NabuCasa/yellow/(threads)

Thread 60 (2023-04-10):

BOM File

gui28347, 2023-04-10:
Could you include the bom file in the release of project ?

agners, 2023-08-21:
Our BOM workflow is rather custom because of requirements from our factory.

However, you can use the KiCad design files to generate a BOM file rather easily.

Closed 2023-08-21.

Thread 61 (2023-04-21):

Fan header and RGB lights

t3hk0d3, 2023-04-21:
Is there any reason why they are not mentioned anywhere in documentation?

agners, 2023-05-10:
They aren't soldered on, so we didn't deem to document those. Especially the controller for the RGB lights wouldn't be easy to populate for most people. And folks who can do it are probably fine looking at the schematics/layout directly :smile:

t3hk0d3, 2023-05-10:
@agners Just out of curiosity - what is a point having these on PCB, but never soldering them? Base for future versions/modifications?

agners, 2023-05-10:
> @agners Just out of curiosity - what is a point having these on PCB, but never soldering them? Base for future versions/modifications?

Essentially component shortage fallout. It was late to implement PCB modifications so we just went for assembly options. We did consider adding it later, but it seems a bit late at this point, since people are used to and documentation has been written etc. etc..

agners, 2023-05-10:
> I am still trying to figure out how to make them work with device tree :D

Yeah that was the other problem: I think it requires kernel source modifications as well :sweat_smile:

Here you can find some nuggets to get that going :smile:
<https://github.com/NabuCasa/raspberrypi-linux/commits/rpi-5.10.y-ha-led-lp5569-forums>

t3hk0d3, 2023-05-15:
> > @agners Just out of curiosity - what is a point having these on PCB, but never soldering them? Base for future versions/modifications?
>
> Essentially component shortage fallout. It was late to implement PCB modifications so we just went for assembly options. We did consider adding it later, but it seems a bit late at this point, since people are used to and documentation has been written etc. etc..

Any chance for `Home Assistant Yellow Max` version? 😉

Closed 2023-05-10.

Thread 63 (2023-08-21):

Google Coral USB Stick

arne182, 2023-08-21:
Is there a way to get a USB 3.0 interface so that I can use the full potential of the Google Coral Stick?

agners, 2023-08-21:
The Raspberry Pi Compute Module 4 has no native USB 3.0 support. The way USB 3.0 is implemented on Raspberry Pi and other boards is through a PCIe to USB 3.0 bridge.

On Yellow the PCIe lines are routed to the M.2 connector. Technically, you can use a M.2 PCIe to USB 3.0 adapter, but they don't seem all that common in practice.

Anther way would be to build a M.2 module with a PCIe to USB 3.0 bridge and a Coral on-board. It seems that there are designs out there for such a device, see https://github.com/will127534/Coral-USB3-M2-Module.

But from a Yellow perspective, there is no plans to build a variant which comes with a PCIe to USB 3.0 bridge on-board.

Closed 2023-08-21.

Thread 64 (2024-11-27):

Will Home Assistant Yellow Be Compatible with CM5?

jotai-dev, 2024-11-27:
I’m considering purchasing the Home Assistant Yellow. Currently, I plan to use the CM4, but I’d like to upgrade to the CM5 once it becomes available. Will this be possible?

I checked the [forward guidance PDF](https://pip.raspberrypi.com/categories/945-forward-guidance) and noticed that some pinouts have been changed on the CM5. Will this affect compatibility?

Closed 2024-11-28.
