NabuCasa/yellow/(commit log)

2021-01-12 Initial commit
    Project creation, imported Compute Module 4 symbol and footprint from
    Gitlab merge requests:
    https://gitlab.com/kicad/libraries/kicad-symbols/-/merge_requests/3158
    https://gitlab.com/kicad/libraries/kicad-footprints/-/merge_requests/2562
    [CM4.kicad_sch, LightBlue.kicad_pcb, LightBlue.kicad_sch]
2021-01-12 Add symbols to schematics, add Symbol for stacked USB 2.0 connector
    [CM4.kicad_sch, LightBlue.kicad_sch, USB.kicad_sch]
2021-01-12 Add USB2422 2-Port Hub and footprint
    [LightBlue.kicad_sch, USB.kicad_sch]
2021-01-13 Add Molex 2086588131 HDMI connector
    [CM4.kicad_sch, LightBlue.kicad_sch]
2021-01-13 Add Silicon Labs MGM210P symbol and footprint
    [LightBlue.kicad_sch, Radio.kicad_sch]
2021-01-13 Add sheet for audio
    [Audio.kicad_sch, LightBlue.kicad_sch]
2021-01-13 Add Ethernet plug symbol and footprint
    [Ethernet.kicad_sch, LightBlue.kicad_sch]
2021-01-14 Add PCIe M.2 support
    [LightBlue.kicad_sch, PCIe.kicad_sch]
2021-01-14 Wire up PCIe/M.2 connector
    [CM4.kicad_sch, LightBlue.kicad_sch, PCIe.kicad_sch]
2021-01-14 Connect HDMI plug
    [CM4.kicad_sch, LightBlue.kicad_sch]
2021-01-14 Wire Ethernet
    [CM4.kicad_sch, Ethernet.kicad_sch, LightBlue.kicad_sch]
2021-01-16 Add sheet for front/RTC, add buttons, LEDs and a RGB LED
    [CM4.kicad_sch, FrontRTC.kicad_sch, LightBlue.kicad_sch]
2021-01-16 Wire up TI PCM5121 audio connect
    [Audio.kicad_sch]
2021-01-16 Multiple changes in schematic & projects:
    -Added net classes for controlled impedance traces
    -Added power hierarchical sheet
    -Initial USB subsystem schematic
    -Added multiple bus definitions (usb, pcie, i2c etc.)
    -Fixed busses use
    -Added LDO for audio analog rails
    [Audio.kicad_sch, CM4.kicad_sch, Ethernet.kicad_sch, FrontRTC.kicad_sch, LightBlue.kicad_sch, PCIe.kicad_sch, Power.kicad_sch, USB.kicad_sch]
2021-01-16 USB.kicad_sch: Fix hub DFP polarity
    [USB.kicad_sch]
2021-01-16 Changes: -Added AP64501SP-13 library symbol -Initial power supplies schematics -Increased capacitance for PCIe socket -Connections between sheets
    [Audio.kicad_sch, CM4.kicad_sch, Ethernet.kicad_sch, FrontRTC.kicad_sch, LightBlue.kicad_sch, PCIe.kicad_sch, Power.kicad_sch, USB.kicad_sch]
2021-01-16 Replace LP5562 with LP5569 for more RGB LED support
    The package is also larger and easier to assemble.
    [FrontRTC.kicad_sch]
2021-01-17 Changes -Added sdcard sheet and SD bus -changed main i2c bus -added 1.8V and 3.3V connection to CM4 -removed clk32 from led driver -fixed PCM interface Data pin
    [Audio.kicad_sch, CM4.kicad_sch, FrontRTC.kicad_sch, LightBlue.kicad_sch, PCIe.kicad_sch, USB.kicad_sch, sdcard.kicad_sch]
2021-01-17 LightBlue.kicad_sym: add SD_DETECT to CM4 symbol
2021-01-17 Wired up SD card
    [LightBlue.kicad_sch, sdcard.kicad_sch]
2021-01-17 Add UART for Zigbee and wire up control signals
    [CM4.kicad_sch, LightBlue.kicad_sch, Radio.kicad_sch]
2021-01-17 Wire up MGM210P Zigbee radio
    [Radio.kicad_sch]
2021-01-18 -Connected remaining nets -CM4 symbol fixups -Used single 6x OE buffer chip instead of 4x single -Added PWM FAN
    [Audio.kicad_sch, CM4.kicad_sch, Ethernet.kicad_sch, FrontRTC.kicad_sch, LightBlue.kicad_sch, PCIe.kicad_sch, Radio.kicad_sch, USB.kicad_sch]
2021-01-24 PoE and clean-up
    - Moved PoE to a seperate sheet and finished design
    - Started using Config field for Variants and DNP flag
    - Fix-ups
    - Added Wurth 749119550 and TI TPS23734 to the symbol library
    - Changed RTC from PCF8563 to PCF85063
    [Audio.kicad_sch, CM4.kicad_sch, Ethernet.kicad_sch, FrontRTC.kicad_sch, LightBlue.kicad_sch, PCIe.kicad_sch, Power.kicad_sch, Radio.kicad_sch]
2021-01-24 poe.kicad_sch: Flip the optocoupler
    [poe.kicad_sch]
2021-01-24 Update Manufacturer/PartNumber in Front/RTC
    [FrontRTC.kicad_sch]
2021-01-24 Update Manufacturer/PartNumber accross the whole schema
    [Audio.kicad_sch, CM4.kicad_sch, Ethernet.kicad_sch, FrontRTC.kicad_sch, LightBlue.kicad_sch, PCIe.kicad_sch, Power.kicad_sch, Radio.kicad_sch]
2021-01-24 Annotate symbools and assign capacitor footprints
    [Audio.kicad_sch, CM4.kicad_sch, Ethernet.kicad_sch, FrontRTC.kicad_sch, LightBlue.kicad_sch, PCIe.kicad_sch, Power.kicad_sch, Radio.kicad_sch]
2021-01-25 Standardize page settings/add page titles
    [Audio.kicad_sch, CM4.kicad_sch, Ethernet.kicad_sch, FrontRTC.kicad_sch, LightBlue.kicad_sch, PCIe.kicad_sch, Power.kicad_sch, Radio.kicad_sch]
2021-01-25 Define more footprints and update Manufacturer/PartNumber fields
    [CM4.kicad_sch, Ethernet.kicad_sch, FrontRTC.kicad_sch, LightBlue.kicad_sch, Power.kicad_sch, USB.kicad_sch, poe.kicad_sch, sdcard.kicad_sch]
2021-01-25 Add footprint for 3.5mm Plug CUI SJ2-35953A-SMT-TR
    Add 3.5mm Audio plug footprint for CUI SJ2-35953A-SMT-TR and assign it.
    Define Config to be +Audio for audio components.
    [Audio.kicad_sch]
2021-01-25 Add TPS23734 footprint
    Add footprint for PoE controller TI TPS23734. Also fix/readd
    Manufacturer which somehow got lost when opening.
    [LightBlue.kicad_sch, poe.kicad_sch, sdcard.kicad_sch]
2021-01-26 Define footprint for remaining parts
    - Fix footprint for 02x05 pin header
    - Add footprint for Bourns SDR1006 Inductor (PoE)
    - Define footprints for inductors
    - Define footprints for ferrite beads
    - Define footprint for fuse
    - Define footprints for all resistors
    - Define footprints for SD card and other components
    - Switch ON Semi NCP114MX with TI TLV73333PDBV
    [Audio.kicad_sch, CM4.kicad_sch, Ethernet.kicad_sch, FrontRTC.kicad_sch, LightBlue.kicad_sch, PCIe.kicad_sch, Power.kicad_sch, Radio.kicad_sch]
2021-01-26 Fix CM4 footprint, assign mounting holes/fiducials
    [CM4.kicad_sch, LightBlue.kicad_sch, poe.kicad_sch]
2021-01-26 Update Schematic to latest KiCad nightly
    [Audio.kicad_sch, CM4.kicad_sch, Ethernet.kicad_sch, FrontRTC.kicad_sch, LightBlue.kicad_sch, PCIe.kicad_sch, Power.kicad_sch, Radio.kicad_sch]
2021-01-26 Update property ids
    Make sure property ids are unique within a symbol. This should avoid
    that Manufacturer properties disappear in the future.
    [CM4.kicad_sch, Radio.kicad_sch, poe.kicad_sch, sdcard.kicad_sch]
2021-01-26 Select existing standard footprint for USB2422
    [LightBlue.kicad_sch, USB.kicad_sch]
2021-01-26 Add and assign footprint for PoE transformer
    We use Wuerth 749119550 as PoE transformer. Add and assign the footprint
    for it.
    [LightBlue.kicad_sch, poe.kicad_sch]
2021-01-26 Add Heatsink footprint
    [LightBlue.kicad_sch]
2021-01-26 Use SH as pad name for shield
    The KiCad standard HDMI symbol uses SH for shield, so use this pad name
    in the footprint as well.
2021-01-26 Use 2x5 pin header to expose extra pads of MGM210P
    [LightBlue.kicad_sch, Radio.kicad_sch]
2021-01-27 Add basic PCB outline
    Use a 120x120mm PCB with corners of radius 20mm.
    [LightBlue.kicad_pcb]
2021-01-27 Add M.2 M-Key footprint with mounting holes for 2230/2242/2260/2280
    [LightBlue.kicad_sch, PCIe.kicad_sch]
2021-01-27 Initial layout with footprint placements
    [LightBlue.kicad_pcb]
2021-01-30 Add 3D models to a couple of footprints
    Add repository with 3D models as git submodule to the repository and
    reference our footprints to the matching 3D models.
2021-02-02 [WIP] PCB commit
    [Ethernet.kicad_sch, FrontRTC.kicad_sch, LightBlue.kicad_pcb, LightBlue.kicad_sch, USB.kicad_sch, poe.kicad_sch, sdcard.kicad_sch]
2021-02-02 Add LightPipe symbol and add 6 of them to the schematics
    [LightBlue.kicad_sch]
2021-02-02 Add Light Pipes
    Add Light Pipes and densify front a bit.
    [LightBlue.kicad_pcb]
2021-02-02 Use through-hole connectors for SiLabs Debug/GPIO pin-header
    We don't plan to populate those connectors by default. The through-hole
    ones are easier to solder by hand on a populated PCB.
    [LightBlue.kicad_sch, Radio.kicad_sch]
2021-02-02 Properly name footprint according to part name
    The 1- at the start of the part number denotes M-Key which is a rather
    important distinction. Fix the footprint name.
    [LightBlue.kicad_sch, PCIe.kicad_sch]
2021-02-02 Define 3D models and offsets for KiCad footprints
    [LightBlue.kicad_pcb]
2021-02-02 Change TPD4EUSB30 symbol for pass-through routing
    Make the pads next to each input pad a passive connection as well to
    allow pass-through routing.
    [Ethernet.kicad_sch, USB.kicad_sch]
2021-02-09 PCB[WIP]/SCH:
    changes:
    -more routing
    -added poe negotiation disabled when +12V is present on the DC jack
    -modified m.2 "holes"
    [CM4.kicad_sch, LightBlue.kicad_pcb, LightBlue.kicad_sch, Power.kicad_sch, USB.kicad_sch, poe.kicad_sch]
2021-02-09 PCB[WIP]: finished routing
    TODO
    - length matching
    - review
    - silkscreen
    [Ethernet.kicad_sch, LightBlue.kicad_pcb]
2021-02-09 Fix RJ45 connector footprint
    Define that the mechanical holes have no electrical property.
2021-02-09 Update footprints to get DRC fixes
    [LightBlue.kicad_pcb]
2021-02-09 Fix DRC warnings/errors
    - Courtyard between R36 and SD card slot
    - Distance between CM4_DBG via and tracks
    [LightBlue.kicad_pcb]
2021-02-09 PCB changes
    - Moved R1 to outside of CM4 courtyard
    - Matched all diff. pairs skew
    - Increased length of the SD_CLK above all other sd traces
    - few trace fixups
    [LightBlue.kicad_pcb]
2021-02-09 Change connector reference designators
    Make them ordered logically, based importance and placement on the
    board.
    [CM4.kicad_sch, LightBlue.kicad_pcb, LightBlue.kicad_sch, Power.kicad_sch]
2021-02-09 Improve connector silkscreen placements
    [LightBlue.kicad_pcb]
2021-02-09 Improve SW and D (LED) ordering and silkscreen
    Make sure switches (SW) are ordered logically. Also use D1 through D6
    for LEDs.
    [Audio.kicad_sch, CM4.kicad_sch, Ethernet.kicad_sch, FrontRTC.kicad_sch, LightBlue.kicad_pcb, LightBlue.kicad_sch, PCIe.kicad_sch, Power.kicad_sch]
2021-02-09 Use Board Design Rules suitable for Aisler
    Bump edge to copper distance to 0.3mm. Fix a problematic via.
    [LightBlue.kicad_pcb]
2021-02-09 Fix silk screen placements
    Improve/fix most silk screen placement of most parts. Decrease size to
    0.8mm by 0.8mm and 0.15mm thickness which works for most PCB manufacturers.
    [LightBlue.kicad_pcb]
2021-02-09 PCB: Silkscreen fixups
    [LightBlue.kicad_pcb]
2021-02-09 Fix silkscreen overlap in footprints
2021-02-09 Simplify footprint of heatsink
    Only draw corner outlines.
2021-02-09 Import fixes footprints and some additional silk screen fixes
    [LightBlue.kicad_pcb]
2021-02-09 Unhide some silkscreen and place them a bit remote
    [LightBlue.kicad_pcb]
2021-02-09 Add Home Assitant logo footprint and place it on PCB
    Add a new footprint for the Home Assitant Logo and place it on the
    backside of the PCB.
    [LightBlue.kicad_pcb]
2021-02-09 Add project name and revision to silkscreen
    [LightBlue.kicad_pcb]
2021-02-11 Import fixed 3D models for stacked USB-A connector and 3.5mm Jack
    Also use the new origin of those 3D models.
    [LightBlue.kicad_pcb]
2021-02-11 More 3D model fixes
    Make sure the right path to 3D models is set in various footprints on
    the PCB. Assign the M.2 footprint from our 3D library.
    [LightBlue.kicad_pcb]
2021-02-15 Fix part number for Audio Jack
    Use 3-pin part instead of 4-pin part by defaut (SJ2-35953A-SMT-TR).
    [Audio.kicad_sch]
2021-02-15 Add CM4 board to board connectors
    Add the CM4 board to board connectors using separate symbols. This is a
    bit a hack, but makes sure two pieces appear in the BOM.
    Also, this seems to upgrade all the schematic to the latest KiCad
    schematic version.
    [Audio.kicad_sch, CM4.kicad_sch, Ethernet.kicad_sch, FrontRTC.kicad_sch, LightBlue.kicad_sch, PCIe.kicad_sch, Power.kicad_sch, Radio.kicad_sch]
2021-02-16 Fix footprint of the PoE bulk capacitor C80
    Use the correct footprint for the PoE bulk capacitor C80. The TI
    evaluation module circuit uses a Panasonic EEE-FK1J470P bulk capacitor.
    The series has other better suited alternatives like EEE-HA1J470UP, but
    the F-size code seems to be a sensible choice.
    Fixes: #1
    [LightBlue.kicad_sch, poe.kicad_sch]
2021-02-16 Replace Ohm sign with R
    Adhere to our KiCad Style Guide and use R instead of the Ohm sign.
    [Ethernet.kicad_sch, LightBlue.kicad_sch]
2021-02-16 Specify charactristics of 0805 resistor in PoE
    The reason we choose 0805 over 0402 is the required Wattage. Specify it
    in the charactristics.
    [poe.kicad_sch]
2021-03-04 Use correct Manufacturer/Part Number for SW5 (recovery switch)
    Fixes: #3
    [FrontRTC.kicad_sch]
2021-03-04 Connect RTC VDD/VSS correctly
    Fixes: #4
    [FrontRTC.kicad_sch]
2021-03-04 Use the correct Part Number for the Würth PoE Transformer
    Fixes: #2
    [poe.kicad_sch]
2021-03-04 sdcard.kicad_sch: add 10k pull-up on SD.PWR
    During boot process cm4 puts that pin briefly in input mode.
    [sdcard.kicad_sch]
2021-03-04 FrontRTC.kicad_sch: fix C64 value
    volt symbol was not capitalised.
    [FrontRTC.kicad_sch]
2021-03-04 USB.kicad_sch: Add CRFILT cap and adjust resistors
    CRFILT capacitor is required for the chip to start properly
    and 10k pull-downs were too strong according to the datasheet.
    [USB.kicad_sch]
2021-03-12 Add pull-ups for Radio.~RESET/~BOOT
    Make sure those signals are well defined even when not be driven from
    the CM4 side. Also rename Radio.BOOT to Radio.~BOOT since its a low
    active signal.
    Fixes: #10
    [CM4.kicad_sch, LightBlue.kicad_sch, Radio.kicad_sch]
2021-03-24 Replace CUI SJ2-35953A with through hole HRO PJ-3973-6A
    Use a through hole 3.5mm Audio jack to make sure it does nto get teared
    off the board accidentially that easily.
    Fixes: #9
    [Audio.kicad_sch, LightBlue.kicad_sch]
2021-04-08 Replace CP2102N and SW4
    Use a jumper instead of a switch to change between CM4 USB Device and
    CP2102N. Replace CP2102N QFN24 with QFN20 variant. Make CP2102N to be
    bus-powered by default.
    Fixes: #7
    [USB.kicad_sch]
2021-04-12 Use HRO USB-C part number to match footprint
    The footprint is not compatible with the JAE part. Specify the HRO USB-C
    part number instead.
    Fixes: #14
    [USB.kicad_sch]
2021-04-13 Replace Diodes AP64501SP-13 with Rohm BD9D321EFJ DC-DC converter
    The Rohm has a lower current rating and input voltage range, but should
    be good enough for our use case. It has better availability and is quite
    a bit cheaper than the Diodes part. This also requires different
    inductors and some different resistor values.
    Fixes: #12
    [Power.kicad_sch]
2021-04-13 Fix CP2102N footprint
    Choose Silicon Labs specific QFN20 footprint.
    [USB.kicad_sch]
2021-04-13 Redesign buttons/switches
    Remove power/reset/recovery switch. Power and reset is not really required
    and recovery mode (USB Boot) can be triggered via jumper. Make the Fan
    and RPiLED a new separate config so we can leave them unpopulated. Add a
    second GPIO controlled switch.
    Fixes: #16
    [CM4.kicad_sch, ControlRTC.kicad_sch, LightBlue.kicad_sch, USB.kicad_sch]
2021-04-13 Replace full sized HDMI with micro HDMI
    Fixes: #17
    [CM4.kicad_sch]
2021-04-13 Assign footprints and annotate components
    [Audio.kicad_sch, CM4.kicad_sch, ControlRTC.kicad_sch, Ethernet.kicad_sch, LightBlue.kicad_sch, PCIe.kicad_sch, Power.kicad_sch, Radio.kicad_sch]
2021-04-13 Power.kicad_sch: Move to ceramic capacitors
    [Power.kicad_sch]
2021-04-14 Adjust PCB outline and placement of connectors/buttons
    Adjust the PCB outline and placement of buttons and connectors for the
    next Prototype iteration.
    [LightBlue.kicad_pcb]
2021-04-14 Add ideal Diode using FET for non-PoE variant
    [LightBlue.kicad_sch, Power.kicad_sch]
2021-04-14 Adjust input/output capacitors for 5V/3.3V supply
    Add/change some capacitor to be 33uF bulk capacitors.
    [LightBlue.kicad_sch, Power.kicad_sch]
2021-04-15 LightBlue.kicad_sym: Add Pulse PA2467NL symbol
2021-04-15 PoE: Migrate to opto-less feedback topology
    [LightBlue.kicad_sch, poe.kicad_sch]
2021-04-15 Use CamelCase style naming for all schematic files
    [LightBlue.kicad_sch, PoE.kicad_sch, SDCard.kicad_sch]
2021-04-15 Adjust Manufacturer/PartNumber for some parts
    - Use Diodes B2100-13-F consistently
    - Define part for pin headers
    - Replace N-Channel MOSFET for PoE with BSZ440N10NS3GATMA1
    - Define Input protection MOSFET DMP3013SFV-7
    [CM4.kicad_sch, Ethernet.kicad_sch, LightBlue.kicad_sch, PoE.kicad_sch, Power.kicad_sch, USB.kicad_sch]
2021-04-15 Add resistors to potentially tune boost converter
    [LightBlue.kicad_sch, Power.kicad_sch]
2021-04-15 Adjust various parts to improve BOM
    - Replace unusual/high value ceramics with lower value in parallel
    - Use the same protection Shottky Diode in PoE as in regular input
    (B340LB-13-F)
    - Replace PoE rectifier Diodes with B1100-13-F
    - Replace PoE Inductor (SRN6045TA-3R3Y) with the same part from 5V power
    supply (Taiyo Yuden NRS8030T3R3MJGJ)
    - Correctly specify Pulse Electronics transformer
    [ControlRTC.kicad_sch, LightBlue.kicad_sch, PoE.kicad_sch, Power.kicad_sch, USB.kicad_sch]
2021-04-15 Reannotate the complete schematics
    [Audio.kicad_sch, CM4.kicad_sch, ControlRTC.kicad_sch, Ethernet.kicad_sch, LightBlue.kicad_sch, PCIe.kicad_sch, PoE.kicad_sch, Power.kicad_sch]
2021-04-16 Adjust rating/footprint size of some ceramic capacitors
    Also update connector/jumper designator to make more sense.
    [Audio.kicad_sch, CM4.kicad_sch, Ethernet.kicad_sch, LightBlue.kicad_pcb, LightBlue.kicad_sch, PoE.kicad_sch, Power.kicad_sch, USB.kicad_sch]
2021-04-16 Add PG-TSDSON-8-1 package for Infineon BSZ440N10NS3
    Add package for Infineon N-Channel MOSFET BSZ440N10NS3.
    [LightBlue.kicad_sch, PoE.kicad_sch]
2021-04-16 Add footprint for Pulse PA2467NL transformer
    [LightBlue.kicad_sch, PoE.kicad_sch]
2021-04-16 Use main 3.3V for CP2102N
    Instead of using VBUS to power CP2102N use the main/NVMe 3.3V supply.
    This makes sure that the device stays powered during reset, while making
    sure the CP2102N is always powered and doesn't backfeed if no USB is
    plugged in.
    [LightBlue.kicad_sch, USB.kicad_sch]
2021-04-16 Rework PCB Layout
    Adjust some high level placement like M.2 or CM4 and heatsink. Remove
    all traces and vias since most of the layouting has to be redone
    anyways.
    [CM4.kicad_sch, Ethernet.kicad_sch, LightBlue.kicad_pcb, LightBlue.kicad_sch, Radio.kicad_sch, USB.kicad_sch]
2021-04-20 Place RGB LEDs between NVMe and CM4
    [LightBlue.kicad_pcb]
2021-04-22 Increase hole size to fit M3
    The current M2.5 holes work well for the soldered nuts from JAE
    (SM3ZS067U310-NUT1-R1800). However, we are going to use a custom
    standoff with a M2 thread (nut) and a screw to mechanically secure the
    NVMe. The nut will have a border to fit the hole. That the standoff
    still can fit a M2 thread we need M3 holes.
2021-04-22 Update M.2 footprint
    Update M.2 footprint and assign 3D model.
    [LightBlue.kicad_pcb]
2021-04-22 Update board setup
    Use minimal track width/gap of 0.127mm. Use impedance calculated using
    the JLCPCB calculator for the 85Ohm/90Ohm differential pairs and 50Ohm
    single trace.
    For the 100Ohm pair the JLCPCB calculator does not allow to specify a
    track gap which leads to a track width of 0.127mm or bigger. Hence for
    this I used https://www.mantaro.com/resources/impedance-calculator.htm
    (with Er 4.05, h 0.095, t 0.035).
    Also use vias of 0.45/0.2mm by default.
    Fixes: #6
2021-04-22 Change button length and start layouting
    Change the length and positioning of the buttons and start layouting a
    bit. Move components where needed.
    [LightBlue.kicad_pcb]
2021-04-23 Use impedance for JLC7628 stackup/switch HDMI/SW2 placement
    Use JLC7628 impedance values to get more options in color selection.
    Also this leads to slightly wider traces typically, and it will be
    easier to switch back to JLC2313 or the like than the other way around.
    Also swap placing of HDMI/SW2 and rotate the heatsink by 90° for easier
    routing.
    [CM4.kicad_sch, ControlRTC.kicad_sch, Ethernet.kicad_sch, LightBlue.kicad_pcb, LightBlue.kicad_sch, USB.kicad_sch]
2021-04-27 pcb 0.2:
    Changes:
    Footrints:
    -Modified DC Jack to accomodate CUI PJ-002A
    -Modified RJ45 to increase clearance between shield and poe pins
    -Modified m.2 mounting pads to avoid drc errors
    Schematic:
    -usb-c facing usb mux is supplied by +3v3VP
    -added misc. capacitors
    PCB
    -min. annular ring for vias set to 0.125 from 0.2
    [CM4.kicad_sch, ControlRTC.kicad_sch, LightBlue.kicad_pcb, LightBlue.kicad_sch, PoE.kicad_sch, Power.kicad_sch, USB.kicad_sch]
2021-04-27 Update silkscreen/adjust reference designators
    Order some relevant reference designator. Use JP for all jumpers. Place
    silkcreen neatly. Add some custom silk screen. Remove heat sink corner
    marks on silk screen.
    [CM4.kicad_sch, Ethernet.kicad_sch, LightBlue.kicad_pcb, LightBlue.kicad_sch, PCIe.kicad_sch, PoE.kicad_sch, SDCard.kicad_sch, USB.kicad_sch]
2021-04-27 pcb fixups and cleanup
    -Moved 5V dcdc converter to clear the heatsink and the LED
    -adjusted gnd plane around the radio module
    [LightBlue.kicad_pcb]
2021-04-27 Ventilation holes and silk screen
    - Add multiple ventilation slots (move some traces for space)
    - Add Home Assistant logo to the back
    - Add Nabu Casa logo on the front
    - Fixup reference designators placement in several cases
    [CM4.kicad_sch, Ethernet.kicad_sch, LightBlue.kicad_pcb, USB.kicad_sch]
2021-04-27 Adjust edge cuts to fit case
    Make sure the PCB doesn't conflict with the case's fasteners.
    [LightBlue.kicad_pcb]
2021-04-27 Use plated slots and adjust 5V trace to be above the GND plane
    [LightBlue.kicad_pcb]
2021-05-10 Fix top right corner radii
    Make sure the top right corner uses the same radii as the other three
    corners.
    Fixes: #23
    [LightBlue.kicad_pcb]
2021-05-29 Use 0805 package for Audio 2.2uF/25V capacitors
    Fixes: #20
    [Audio.kicad_sch, LightBlue.kicad_sch]
2021-05-29 Change rating of PoE capacitors to 2.2uF/25V
    2.2uF/100V are not really available in a 0805 package. This part of
    the PoE design a 25V rating is sufficent.
    Fixes: #22
    [LightBlue.kicad_sch, PoE.kicad_sch]
2021-05-29 Clarify rating of C52/R53
    C52 needs to be 100n/25V, R53 should be 1% accuracy.
    [LightBlue.kicad_sch, PoE.kicad_sch, Power.kicad_sch]
2021-05-29 Change footprint of C87/C91 to 1206
    2.2uF/100V don't really exist in 0805 package. Use 1206 package for
    those capacitors.
    Fixes: #21
    [LightBlue.kicad_sch, PoE.kicad_sch]
2021-05-29 Use 3D model for Lite-OnLTST-C19HE1WT RGB LED
    [LightBlue.kicad_pcb]
2021-05-29 Set origin to match top left corner of the board
    This makes sure that the origin aligns with the top left corner of the
    board when importing the PCB using FreeCAD KiCadStepUp.
    [LightBlue.kicad_pcb]
2021-05-29 Improve Heatsink footprint and position
    Make the heat sink footprint to represent the real heatsink without
    rotation and the correct outer dimension (56x56mm). Also position the
    heatsink centered on the CM4 SoC.
    [LightBlue.kicad_pcb]
2021-05-29 Use HDMI Type D (mini HDMI) Symbol
    This fixes assignment of pins to properly match HDMI Type D pinout.
    Fixes: #24
    [CM4.kicad_sch, LightBlue.kicad_sch]
2021-06-03 move LEDs and place ventilation holes around it
    Also add some additional ventilation holes and make them slightly
    larger.
    [LightBlue.kicad_pcb]
2021-06-05 initial rev 0.3:
    updates
    schematic:
    -change usb current protection IC to 1.5A
    -Added low-pass filter to the audio output
    -PoE fixed primary windings polarity
    -added option to select poe class with a jumper (between 3 and 4)
    -fixes in poe design
    -added testpoints
    -added virtual hirose df40c connectors for pick and place use
    lightblue.pretty:
    -added fake DF40C footprint for pick and place and 3d model purposes
    [Audio.kicad_sch, CM4.kicad_sch, ControlRTC.kicad_sch, LightBlue.kicad_pcb, LightBlue.kicad_sch, PoE.kicad_sch, Power.kicad_sch, Radio.kicad_sch]
2021-06-06 Add mounting holes for LED diffuser
    Add 3.5x2.5mm mounting slits to clip on the LED diffuser.
    [LightBlue.kicad_pcb, LightBlue.kicad_sch]
2021-06-06 Rename Hirose DF40C-100DS-0.4V footprint and add 3D data
    Rename to be more in line with KiCad library convention. Update and
    reference 3D model.
    [CM4.kicad_sch, LightBlue.kicad_pcb, LightBlue.kicad_sch]
2021-06-06 Add plated drill holes to mount LED diffuser
    [LightBlue.kicad_pcb]
2021-06-06 Change orientation of PoE class selector
    Make the PoE class selector pin header horizontal. Also move battery
    holder a bit south and extend PoE GND slightly to make room.
    Also fix placements of silk screen.
    [LightBlue.kicad_pcb]
2021-06-06 Change KISYS3DMOD to KICAD6_3DMODEL_DIR
    All new footprints refer to the 3D model by using KICAD6_3DMODEL_DIR.
    Update the footprints in .kicad_pcb to do the same.
    [LightBlue.kicad_pcb]
2021-06-06 Rotate jumpers by 90°
    Rotate jumpers J2 through J4 by 90° degrees. This makes all jumper
    orient the same and makes space for silk screen.
    [LightBlue.kicad_pcb]
2021-06-06 Move LP5569RTWR LED controller away from light diffuser
    Move the LP5569RTWR LED controller so it doesn't interfere with the
    LED light diffuser if we decide to make it sit directly on the PCB.
    [LightBlue.kicad_pcb]
2021-06-06 Add test points for I2C
    [ControlRTC.kicad_sch, LightBlue.kicad_pcb, LightBlue.kicad_sch]
2021-06-06 Remove duplicate vias and improve routing of SWDIO
    Deal with DRC warnings by either ignoring (like courtyard overlap of
    fiducials) or fixing (removing duplicate vias).
    Also use a shorter route for SWDIO.
    [LightBlue.kicad_pcb]
2021-06-06 Update/add silkscreen for jumpers
    Add new silk screen art for jumpers. Fix some silk screen placement
    necessary.
    [LightBlue.kicad_pcb]
2021-06-06 Add PCB art
    Add text to describe important aspects of the PCB. Fix silkscreen in
    various places.
2021-06-06 Move RPi LEDs and fix Silkscreen
    Move the RPi LEDs closer to the CM4 to make space for PCB Art in the top
    right corner.
    Fix Silkscreen accross the whole board.
2021-06-06 Improve testpoint placement and fix board edge cut
    Move I2C test points away from the Home Assistant logo. Fix edge cuts to
    be exactly 120x120mm.
2021-06-06 Adjust 5V routing and fix 3D model for MOSFETs
    The MOSFET 3D model did not fit the footprint, select a matching model.
    Also adjust 5V routing to avoid an unnecessary via.
    [LightBlue.kicad_pcb]
2021-06-07 Switch to PA version for MGM210P
    Switch the SiLabs Radio module from MGM210PB32JIA2 to MGM210PA32JIA2.
    The PA version has no secure vault but is slightly cheaper. It is
    unlikely that we use the secure vault anytime soon, so let's use the PA
    version.
    [Radio.kicad_sch]
2021-06-07 Update Board Setup to reflect current stackup
    The current trace width/diff pair gap are impedance matched for the
    JLC7628 stackup. Change the board setup to reflect that stackup.
    [LightBlue.kicad_pcb]
2021-07-20 Exclude Logo/SilkScreen art from BOM and position files
    [LightBlue.kicad_pcb]
2021-07-20 Rotate T1 to make sure Pin 1 is at the top left corner
    According to KiCad guidelines Pin 1 should be at the top left corner.
    [LightBlue.kicad_pcb]
2021-07-20 Mark J5/HRO PJ-3973-6A as through hole component
    [LightBlue.kicad_pcb]
2021-07-20 Use new 3D models for Inductors and PoE Transformer
    [LightBlue.kicad_pcb]
2021-07-21 Align BD9D321EFJ DC-DC converts correctly
    Add BD9D321EFJ to the symbol library and align it properly to the
    1.27mm/0.050inch grid. Make sure to align the instances U15/U16
    correctly as well as the complete Power schematic.
    With that GND is now correctly connected to Pin 5 of U16.
    Fixes: #27
    [Power.kicad_sch]
2021-07-21 Update PCB to include latest schematic changes
    This makes sure that U16 Pin 5/9 is correctly connected to GND.
    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
    [LightBlue.kicad_pcb]
2021-08-12 Update project files with latest KiCad 6 nightly
    [Audio.kicad_sch, CM4.kicad_sch, ControlRTC.kicad_sch, Ethernet.kicad_sch, LightBlue.kicad_sch, PCIe.kicad_sch, PoE.kicad_sch, Power.kicad_sch]
2021-08-12 Add second RTC symbol for alternative footprint
    Add a second RTC symbol to support TSSOP-8 footprint besides the
    existing 8-SOIC footprint.
    Fixes: #29
    [ControlRTC.kicad_sch, LightBlue.kicad_sch]
2021-08-12 Deactivate RGB LEDs and use simple LED approach
    Add Amber specific yellow LED as an additional status indicator.
    Do not populate RGB LEDs and LP5569 LED controller.
    Fixes: #32
    [CM4.kicad_sch, ControlRTC.kicad_sch, LightBlue.kicad_sch]
2021-08-12 Use XKB-Connectivity PJ-3270 3.5mm Audio plug
    Replace the HRO part with the XKB part. The HRO part had shorter feet
    which caused issues during soldering.
    Fixes: #30
    [Audio.kicad_sch, LightBlue.kicad_sch]
2021-08-12 Renmae LightBlue to Amber
    [Amber.kicad_pcb, Amber.kicad_sch, Audio.kicad_sch, CM4.kicad_sch, ControlRTC.kicad_sch, Ethernet.kicad_sch, PCIe.kicad_sch, PoE.kicad_sch]
2021-08-13 Use Terminus Tech FE1.1 USB Hub
    Fixes: #28
    [Amber.kicad_sch, CM4.kicad_sch, ControlRTC.kicad_sch, Ethernet.kicad_sch, PoE.kicad_sch, Power.kicad_sch, Radio.kicad_sch, SDCard.kicad_sch]
2021-08-14 Update to LEDs and add GND test point
    - Add Blue Radio LED (in a separate new assembly option)
    - Change buffer package from SC-70 to SC-74A (aka. SOT-23-5)
    - Add GND test point
    Fixes: #31
    [Amber.kicad_sch, CM4.kicad_sch, ControlRTC.kicad_sch, Ethernet.kicad_sch, Radio.kicad_sch, USB.kicad_sch]
2021-08-14 Set Config correctly for PoE only parts
    Fixes: #34
    [PoE.kicad_sch]
2021-08-14 Set Config correct for PoE class selector
    [PoE.kicad_sch]
2021-08-14 Relayout new design
    - Update PCB from Schematics
    - Move SD-card to bottom side of the PCB
    - Place LEDs in front of CM4
    - Add additional LEDs (Amber/Radio)
    - Move LP5569 to the left
    - Remove all holes
    - Lock through holes which should not be moved
    Fixes: #33
    [Amber.kicad_pcb, Amber.kicad_sch, CM4.kicad_sch, ControlRTC.kicad_sch, Ethernet.kicad_sch, Radio.kicad_sch, USB.kicad_sch]
2021-08-17 Changes to PoE for EMI compliance and improved efficiency
    PoE
    -Added a common mode filter on the input
    -FB filter on the output side
    -12V in now disables the poe with the DEN pin
    -DT is now disabled
    -PSRS is now disabled
    -move to 1210 resistors for resistors identified in thermal testing
    -DTHR is now enabled in default BoM
    -some resistor values were adjusted
    -some caps were moved to the common power supply section
    USB:
    -USB Hub 1.8V rail have capacitors added
    [Amber.kicad_sch, Audio.kicad_sch, CM4.kicad_sch, PoE.kicad_sch, Power.kicad_sch, USB.kicad_sch]
2021-08-17 USB: add annotations and switch usb ports for easier routing
    [Amber.kicad_sch, USB.kicad_sch]
2021-08-18 Fix/improve various parts
    - U7: Define Manufacturer/PartNumber
    - J13: Define Manufacturer/PartNumber
    - L2: Fix PartNumber (remove unprintable characters)
    - C85: Change to our preferred supplier Nichicon
    - J9: DNP (not used by default, avoid potential issues with FCC approval)
    - Y1/Y2: Define frequency and load capacitance in value
    - JP1: Use sensible part value
    - C106: Fix Config field
    - Remove heat sink and CM4 from BOM (handled in product assembly BOM)
    [Amber.kicad_sch, CM4.kicad_sch, ControlRTC.kicad_sch, PoE.kicad_sch, Power.kicad_sch, Radio.kicad_sch, USB.kicad_sch]
2021-08-18 Rename Light Blue to Amber in PoE schematic
    Use correct sheet name as well as library reference.
    [PoE.kicad_sch]
2021-08-18 Use non-automotive Murata Common Mode Choke
    - Change FL1 to be Murata Electronics DLW5BTM102SQ2. This version is not
    automotive approved. It is cheaper and has better availability
    currently.
    [PoE.kicad_sch]
2021-08-18 Remove GNDA, add audio/button ESD protection
    [Amber.kicad_sch, Audio.kicad_sch, ControlRTC.kicad_sch, PoE.kicad_sch]
2021-08-18 Add Manufacturer/PartNumber for supporessor diodes
    Also define Config where necessary.
    [Amber.kicad_sch, Audio.kicad_sch, ControlRTC.kicad_sch]
2021-08-19 Add symbol for ESD supporessor diodes
    Add symbol for the "reverse" ESD suppressor diodes. Those are mainly
    required for Audio. Update schematics using this new symbol.
    [Amber.kicad_sch, Audio.kicad_sch, ControlRTC.kicad_sch]
2021-08-23 RaspberryPi-CM4.kicad_mod: Modify mounting holes
    Removed copper on top and bottom and extended the mask
    opening to 6mm
2021-08-23 Add murata common DLW5B mode choke symbol and footprint
2021-08-23 PoE.kicad_sch: fix Vss and remove vss-gnd1 diode
    Vss was pointing to general GND.
    Diode is not used int PSR topology.
    [Amber.kicad_sch, Audio.kicad_sch, ControlRTC.kicad_sch, PoE.kicad_sch, USB.kicad_sch]
2021-08-23 [WIP] PCB design
    Done:
    PoE - primary side,
    DCDC location,
    USB hub location,
    TBD:
    HUB routing,
    PoE sec. side,
    Audio
    [Amber.kicad_pcb]
2021-08-23 Hide parts which we don't intend to assemble in production
    Hide parts which we don't plan to assemble in any SKU we plan for
    production currently. In particular:
    - RGB LEDs
    - SD-card
    - HDMI
    - Fan connector
    [Amber.kicad_pcb]
2021-08-23 Update silkscreen for USB device boot jumper
    Use UBS-C rcvry to make it clear that CM4 will not boot from USB flash
    drive but via USB-C as a USB device.
2021-08-24 Update silkscreen
    - Add new backside silkscreen
    - Update USB recovery silkscreen
    - Move Nabu Casa logo
    - Add ESD warning to silkscreen
    - Update PCB name and revision
    [Amber.kicad_pcb]
2021-08-24 Rename Murata DLW5B
    Align with naming of other Common Mode Chokes. Add pin one marking and
    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
    [Amber.kicad_pcb]
2021-08-24 Small Silkscreen/Model improvements
    - Move J5 silkscreen to be on the PCB
    - Use almost matching Model for CP2102N in QFN20 pacakge
    - Bump revision to 1.0
    [Amber.kicad_pcb]
2021-08-29 [WIP] Amber 1.0 pcb design
2021-08-29 Address DRC issues
    Run annotation again which just updated some net names. Address various
    DRC issues like courtyard violence and exclude the remaining DRC errors.
    [Amber.kicad_sch, CM4.kicad_sch, ControlRTC.kicad_sch, Ethernet.kicad_sch, PoE.kicad_sch, Power.kicad_sch, Radio.kicad_sch, USB.kicad_sch]
2021-08-29 Cleanup parts silkscreen
    Cleanup part reference silkscreen. Change D6 <=> D24 to make the three
    LEDs to be numbered in a row.
    [Amber.kicad_sch, ControlRTC.kicad_sch, PoE.kicad_sch]
2021-08-29 Update/add silkscreen graphics
    Add SVG source files of silk screen graphics. Update them to fit the
    latest layout. Move TP13 to avoid disturbing the text.
2021-08-29 Fix Radio.SWCLK routing, FL1 silk screen and rename D30 to D24
    - Fix Radio.SWCLK routing around U1 hole
    - Place FL1 silk screen properly
    - Rename D30 to D24
    - Remove useless via/track
    [Amber.kicad_sch, ControlRTC.kicad_sch]
2021-08-29 Add voltage/amperage/polarity to back silk screen
    Fixes: #38
2021-08-29 Bump Amber revision to 1.0
    Make sure all drawings are set to 1.0. Update Board stackup (colors) and
    add tables to comment layer.
    [Amber.kicad_sch, Audio.kicad_sch, CM4.kicad_sch, ControlRTC.kicad_sch, Ethernet.kicad_sch, PCIe.kicad_sch, PoE.kicad_sch, Power.kicad_sch]
2021-08-30 Mark Transformer Pulse PA2467NL as PoE only
    Set Config +PoE to make sure that Pulse is only assembled in PoE BOM.
    [PoE.kicad_sch]
2021-10-06 Begin replacing TPS23734 with MPS MP8008
    [PoE.kicad_sch]
2021-10-08 Rework PoE to use MP8008
    [Amber.kicad_sch, CM4.kicad_sch, PoE.kicad_sch]
2021-10-08 Assign Manufacturer/PartNumbers and align parts to 1.27mm grid
    [Amber.kicad_sch, PoE.kicad_sch]
2021-10-30 USB hub fixes
    -Fixed upstream diff pair polarity
    -added optional inverer for the USB power switch enable pin
    Design now supports both AP2181 and AP2191
    [Amber.kicad_sch, PoE.kicad_sch, Power.kicad_sch, USB.kicad_sch]
2021-12-09 Yellow Proto1
    -name changed to yellow
    -moved to 24-pin CP2102N
    -routing
    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
    [Amber.kicad_sch, Audio.kicad_sch, CM4.kicad_sch, ControlRTC.kicad_sch, Ethernet.kicad_sch, PCIe.kicad_sch, PoE.kicad_sch, Power.kicad_sch]
2022-01-05 Fix FSUSB30 Symbol and routing
    Additionally a cap was added to U27.
    [Amber.kicad_pcb, Amber.kicad_sch, Audio.kicad_sch, CM4.kicad_sch, ControlRTC.kicad_sch, Ethernet.kicad_sch, PCIe.kicad_sch, PoE.kicad_sch]
2022-01-06 Rename Amber to Yellow everywhere
    [Audio.kicad_sch, CM4.kicad_sch, ControlRTC.kicad_sch, Ethernet.kicad_sch, PCIe.kicad_sch, PoE.kicad_sch, Power.kicad_sch, Radio.kicad_sch]
2022-01-06 Exclude TestPoints from BOM
    [CM4.kicad_sch, ControlRTC.kicad_sch, Power.kicad_sch, USB.kicad_sch, Yellow.kicad_sch]
2022-01-06 Update PartNumber/Manufacturer
    Fill in Manufacturer/PartNumber for the following parts:
    - CP2102N-Axx-xQFN24
    - FSUSB30MUX
    - BC817
    [Audio.kicad_sch, CM4.kicad_sch, ControlRTC.kicad_sch, Ethernet.kicad_sch, PoE.kicad_sch, Power.kicad_sch, Radio.kicad_sch, SDCard.kicad_sch]
2022-01-07 Fix copy and paste error in Manufacturer property
    [USB.kicad_sch]
2022-01-09 Optimise PoE layout
    [CM4.kicad_sch, PoE.kicad_sch, Yellow.kicad_pcb, Yellow.kicad_sch]
2022-01-09 Add Heatsink outline to footprint
    This helps to align the heatsink properly.
    Fixes: #44
2022-01-09 Silkscreen fixes/small BOM adjustments
    - Update silk screen reference designators
    - Update backside silk screen for Yellow revision 1.1
    - Set U21 (SOIC-8 RTC) to assemble and U25 (MSOP-8) as DNP
    - Update heatsink footprint to add heatsink outline to silk screen (#44)
    - Mark orientation of D26, D27, D28 and D29 (fixes #39)
    - Use pin-header footprint for PoE selector J13, it is now JP5
    [Audio.kicad_sch, CM4.kicad_sch, ControlRTC.kicad_sch, Ethernet.kicad_sch, PCIe.kicad_sch, PoE.kicad_sch, Power.kicad_sch, Radio.kicad_sch]
2022-01-10 Various minor silk screen/PCB tweaks
    - Fix edge cut on lower right corner to make board size exact
    - Update board charactristics
    - Set grid origin back to 30, 30
    - Update M.2 expansion silk screen (remove AI accelerator hint)
    - Various silk screen reference designator fixes/improvements
    - Add ESD warning logo
    [Audio.kicad_sch, CM4.kicad_sch, ControlRTC.kicad_sch, Ethernet.kicad_sch, PCIe.kicad_sch, PoE.kicad_sch, Power.kicad_sch, Radio.kicad_sch]
2022-02-05 Move J11 5.08mm up
    Moved the reduced rPI hat conenctor to accomodate bigger hats
2022-02-14 PoE EMI optimization
    Modified PoE layout to account for GNDS-GND1 flow
    and repositioned the noise retern capacitor.
    Snubber was corrected for the transformer used and the switching
    frequency. Some components were removed.
    PoE Input filter was adjusted.
    3.3 and 5V DCDC capacitor layout was optimised and unused components
    were removed.
    [CM4.kicad_sch, PoE.kicad_sch, Power.kicad_sch, Yellow.kicad_sch]
2022-02-15 Zone cleanup
    Cleanup some fill zones.
    Updated the Transformer symbol with pin 4, connected to +48V for better
    zone fill.
    fixed top/bottom transition for the DC_IN_F
    Added some gnd vias
    [PoE.kicad_sch, Yellow.kicad_pcb]
2022-02-15 Moved PoE few mm lower
    In order to accomodate the C93 next to the transformer.
    Added top layer GND1 pour under the transformer
    shortened the GNDS path.
    [Yellow.kicad_pcb]
2022-02-15 Adjust/fix silkscreen
    - Place reference properly
    - Move and update Wireless smart-home text
    - Move and update PoE+ text
    - Readd symbols and back silkscreen (with proper attributes)
2022-02-15 Bump revision to 1.2
    Bump revision to 1.2 in Schematic/PCB sheets and update the date.
    [Audio.kicad_sch, CM4.kicad_sch, ControlRTC.kicad_sch, Ethernet.kicad_sch, PCIe.kicad_sch, PoE.kicad_sch, Power.kicad_sch, Radio.kicad_sch]
2022-04-22 Add CM4 outlines to silkscreen
    Also adjust line outline thickness of the CM4 and heatsink.
    Fixes #50
2022-04-27 Adjust LED resistors for radio and activity LED
    Set the blue radio LED to 2.2k and the green activity LED to 22k.
    Fixes: #48
    [ControlRTC.kicad_sch, Radio.kicad_sch, Yellow.kicad_sch]
2022-04-27 Schematic/PCB version v1.2b
    Increment to sub-version v1.2. Main changes are:
    - Back and front silk screen
    - LED resistors
    There are no changes in the layout and any critical components.
    [Audio.kicad_sch, CM4.kicad_sch, ControlRTC.kicad_sch, Ethernet.kicad_sch, PCIe.kicad_sch, PoE.kicad_sch, Power.kicad_sch, Radio.kicad_sch]
2022-05-30 workaround for CP2102N backfeeeding from Vio
    [CM4.kicad_sch, USB.kicad_sch, Yellow.kicad_sch]
2022-05-31 Schematic/PCB version v1.2c
    [Audio.kicad_sch, CM4.kicad_sch, ControlRTC.kicad_sch, Ethernet.kicad_sch, PCIe.kicad_sch, PoE.kicad_sch, Power.kicad_sch, Radio.kicad_sch]
2022-05-31 Add assembly option for cp2102n Vbus supply from 3.3V
    [USB.kicad_sch, Yellow.kicad_sch]
2022-05-31 Refill zones as suggested when generating Gerber files
2022-06-13 poe 1.3 improvements for emc includes MPS layout sugestions
    decreased coupling between poe lines and the gnd plane
    added vias to stich main gnd planes
    decreased the peak current through the transformer
    inductor based pi filter on the poe output
    decreased coupling to gnd of the poe "noise path"
    added parallel mosfet capacitance to poe
    moved fb line fo the dcdcs away from inductors
    [CM4.kicad_sch, ControlRTC.kicad_sch, PCIe.kicad_sch, PoE.kicad_sch, Power.kicad_sch, Radio.kicad_sch, USB.kicad_sch, Yellow.kicad_sch]
2022-06-16 Adjust PoE and change 3.3V supply topology
    -Snubber circuit under ecrtail load condition can dissipate more power
    then the resistor can handle, increased the resistor size and added one
    more in parallel
    -Increased size of some of the 12V input capacitors
    -Use 3.3Vp instead of 3.3V generated by the RPi for LED, RTC, Radio, Fan
    control and RPi reduced hat connector
    -PoE pri/sec capacitor value changed
    [CM4.kicad_sch, ControlRTC.kicad_sch, PCIe.kicad_sch, PoE.kicad_sch, Power.kicad_sch, Radio.kicad_sch, USB.kicad_sch, Yellow.kicad_sch]
2022-06-16 Use CM4 3.3V as EN fot 3.3Vp
    -changed snubber circuit diode to a "normal" from schottky
    [ControlRTC.kicad_sch, PoE.kicad_sch, Power.kicad_sch, Yellow.kicad_sch]
2022-06-26 PCB: Adjust GND/GND1 planes
2022-06-28 USB-UART: PCB: Add CP2102n power diode and fix DRC issues
    [ControlRTC.kicad_sch, PoE.kicad_sch, Power.kicad_sch, Radio.kicad_sch, USB.kicad_sch, Yellow.kicad_sch]
2022-06-30 Add proper D30/D31 BOM information
    [USB.kicad_sch]
2022-07-24 EMC optimisations
    -eth shield is not connected to the GND rather it shields "input" of poe
    -used smaller package for bulk PoE capacitor
    -Changed common mode filter to Pulse T8113
    -Added more inductor filters on the primary side
    -replaced secondary side ferrite silter with an inductor
    -used distributed "flyback" capacitor (3 instead of 1)
    -slightly increased distance between the poe transformer and the
    ethernet signal traces
    - extended GND1 under the transformer
    - primary snubber circuit is now in "hot-loop" area
    -repositioned poe enable optocoupler
    [CM4.kicad_sch, Ethernet.kicad_sch, PoE.kicad_sch, USB.kicad_sch, Yellow.kicad_sch]
2022-07-25 Add L1/L4 GND pour
2022-08-29 Yellow 1.3 PCB
    [CM4.kicad_sch, PoE.kicad_sch, USB.kicad_sch, Yellow.kicad_sch]
2022-08-29 BOM adjustments
    Various BOM adjustments, most notably setting/correcting manufacturer
    and part number information for D22, D30, FL1, L4 and L5.
    [Ethernet.kicad_sch, PoE.kicad_sch, USB.kicad_sch, Yellow.kicad_sch]
2022-08-29 Update silk screen and board version
    Adjust silk screen graphics to match current layout. Adjust silk screen
    reference designator placements. Bump date and version of schematics and
    PCB.
    [Audio.kicad_sch, CM4.kicad_sch, ControlRTC.kicad_sch, Ethernet.kicad_sch, PCIe.kicad_sch, PoE.kicad_sch, Power.kicad_sch, Radio.kicad_sch]
2022-10-09 Use colorized tactile switches
2022-10-10 Use 0.05Ohm for R60
    Previous versions used R44/R60 with 0.1Ohm in parallel for easier
    testing. However, with the final version, only the frootprint for
    R60 is in the layout, hence it has to be 0.05Ohm.
    [PoE.kicad_sch, Yellow.kicad_sch]
2022-10-13 Mark JP5 PoE only
    [PoE.kicad_sch]
2022-11-01 Change U29 to actual part used in production
    We are using the onsemi LM431SACM3X alternative in mass production.
    [PoE.kicad_sch]
2022-11-04 Increase hole size to fit M2.5 SMT stand-off nut
    Use the recommended hole size of 4.22mm. Make the outer diameter
    slightly larger than specified as minimum to allow more space for excess
    solder.
    Fixes: #54
2022-11-04 Redesign back silk screen for larger label
    Redesign the back silk screen. The new print provides space for a
    larger label (32x19mm), uses the new Powered By Raspberry Pi logo and
    prints "Made in PRC" onto the PCB.
    Fixes: #52, #55
2022-11-04 Yellow.pretty: new footprints and modificaion of existing ones
    Added:
    - 4.5x4.5mm smd button
    - M2.5 H=1.5mm standoff
    Added/Modified:
    - HTSOP-8 copied from kicad library and added more thermal vias
    - CM4 remove drills from the mounting holes
2022-11-04 Added cm4 standoffs, usb rec. button, DC_IN pull-down
    - solderable standoffs for the CM4
    - DC_IN_F pulldown for D2 high temp reverse current control R44
    Modified:
    - USB recovery jumper JP2 replaced with a button SW3
    - R64 changed to 33k from 6.8k
    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
    [CM4.kicad_sch, PoE.kicad_sch, Power.kicad_sch, USB.kicad_sch, Yellow.kicad_sch]
2022-11-05 Yello.pretty: added solderpaste to SMTSO2515CTJ
2022-11-05 PCB: updated SMTSO2515CTJ footprint
2022-11-06 Yellow.pretty: SMTSO2515CTJ modified
    Remove through hole plating and enforce thermal relieves
2022-11-06 update to the latest symbols and footprints
    Update SMTSO2515CTJ standoff and D3 to latest upstream
    [Power.kicad_sch, USB.kicad_sch, Yellow.kicad_sch]
2022-11-06 Bump to Yellow v1.3b
    Update 3D model locations and bump dates and versions.
    [Audio.kicad_sch, CM4.kicad_sch, ControlRTC.kicad_sch, Ethernet.kicad_sch, PCIe.kicad_sch, PoE.kicad_sch, Power.kicad_sch, Radio.kicad_sch]
2022-12-04 Yello_PCB: expand keepout area for the CM4 wireless antenna
    Due to gnd pour expansion keepout was insufficient.
2022-12-04 Set manufacturer and part number of SMT stand-off/SW3
    [CM4.kicad_sch, Ethernet.kicad_sch, USB.kicad_sch]
2023-02-06 Adjust CR2032 battery holder footprint
    Increase the pad size of the CR2032 battery holder to ensure good
    solder joints.
    Also refill and updated settings for gerber export.
2023-04-06 Converted PCB/Schematic to KiCad 7 format
    This converts PCB/Schematic files to KiCad 7 format. Converted by simply
    opening the project and press save.
    [Audio.kicad_sch, CM4.kicad_sch, ControlRTC.kicad_sch, Ethernet.kicad_sch, PCIe.kicad_sch, PoE.kicad_sch, Power.kicad_sch, Radio.kicad_sch]
2023-04-06 Add Pinion metadata
    Add metadata for Pinion to generate interactive diagrams. The following
    command is being used to generate the diagrams for
    yellow.home-assistant.io:
    $ pinion generate rendered \
    --renderer normal --projection orthographic \
    --board Yellow.kicad_pcb --specification Yellow_PoE_Pinion_Front.yaml
2023-05-10 USB: Add diode to prevent voltage out on USB-C
    [USB.kicad_sch]
2023-06-27 Fix Pinion DC Power Jack diameter
    The Power Jack is 5.5mm not 5.1mm.
    [Yellow_PoE_Pinion_Front.yaml, Yellow_Standard_Pinion_Front.yaml]
2023-09-06 Adjust description of Yellow LED for Pinion
    The Yellow LED is described as system health LED.
